al177/blinkencard/README.md

# blinkencard
FPGA based blinky computer emulator
