al177/blinkencard/(threads)

Thread 8 (2019-12-26):

Keep vias away from silk

al177, 2019-12-26:
Insure that vias stay clear of any silk on the 'front panel' back silk layer. Vias break up silkscreen, and can make the fine text on the front panel illegible. Seems to be done mostly well with V2.0, but back silk layer needs more thorough review for future revs.

The only violations of this are around the 'STATUS' legend under the status LED bank. This is an issue on both v1.0 and v2.0 PCBs.

Closed 2023-09-08.

Thread 9 (2019-12-27):

v2.0 BOM errors

al177, 2019-12-27:
- C1, C2 0.01uF cap is 0805, should be 0603
- D2 green SMD LED is R/A, but footprint is not. R/A facing outward is correct, should change footprint to match.

Closed 2023-09-08.

Thread 10 (2019-12-28):

v2.0 - battery connector polarity is opposite the Adafruit standard

al177, 2019-12-28:
Adafruit 1S LiPo cells use JST-PH connectors like this design, but the polarity is opposite of ours.

For next revision, either choose a different connector, or change polarity to match this semi-standard.

Closed 2023-09-08.

Thread 12 (2019-12-28):

v2.0 - Increase silk text and line width on the front panel

al177, 2019-12-28:
JLCPCB does a reasonable job of printing silk, but their process does not seem consistent from run to run as evidenced by minor gaps in some lines in v2.0 vs v1.0.  Increase the line width for graphics and text to avoid this in the future.

Closed 2023-09-08.

Thread 13 (2020-01-10):

Rotate the battery connector 180 degrees

al177, 2020-01-10:
With the battery connector oriented the way it is, the leads from the battery drape over the ESP32 module antenna. Rotate the connector so this doesn't happen.

Closed 2023-09-08.
