al177/blinkencard/kicad/v2.0/blinkencard.pdf

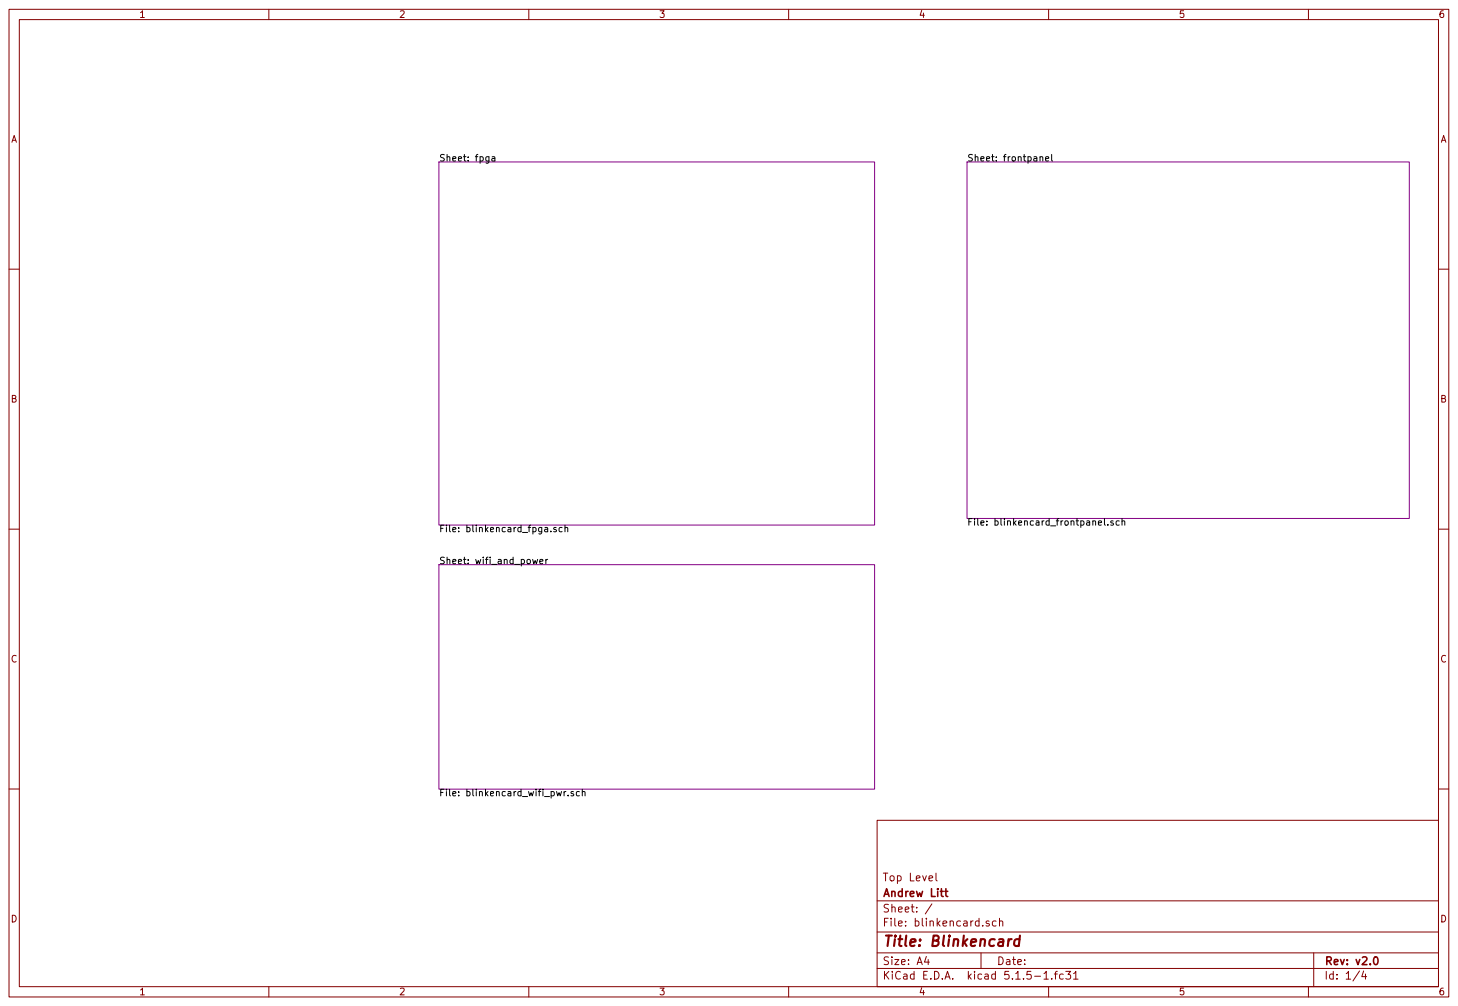
[picture p1: page 1]

File: blinkencard.sch Sheet: / Andrew Litt Top Level

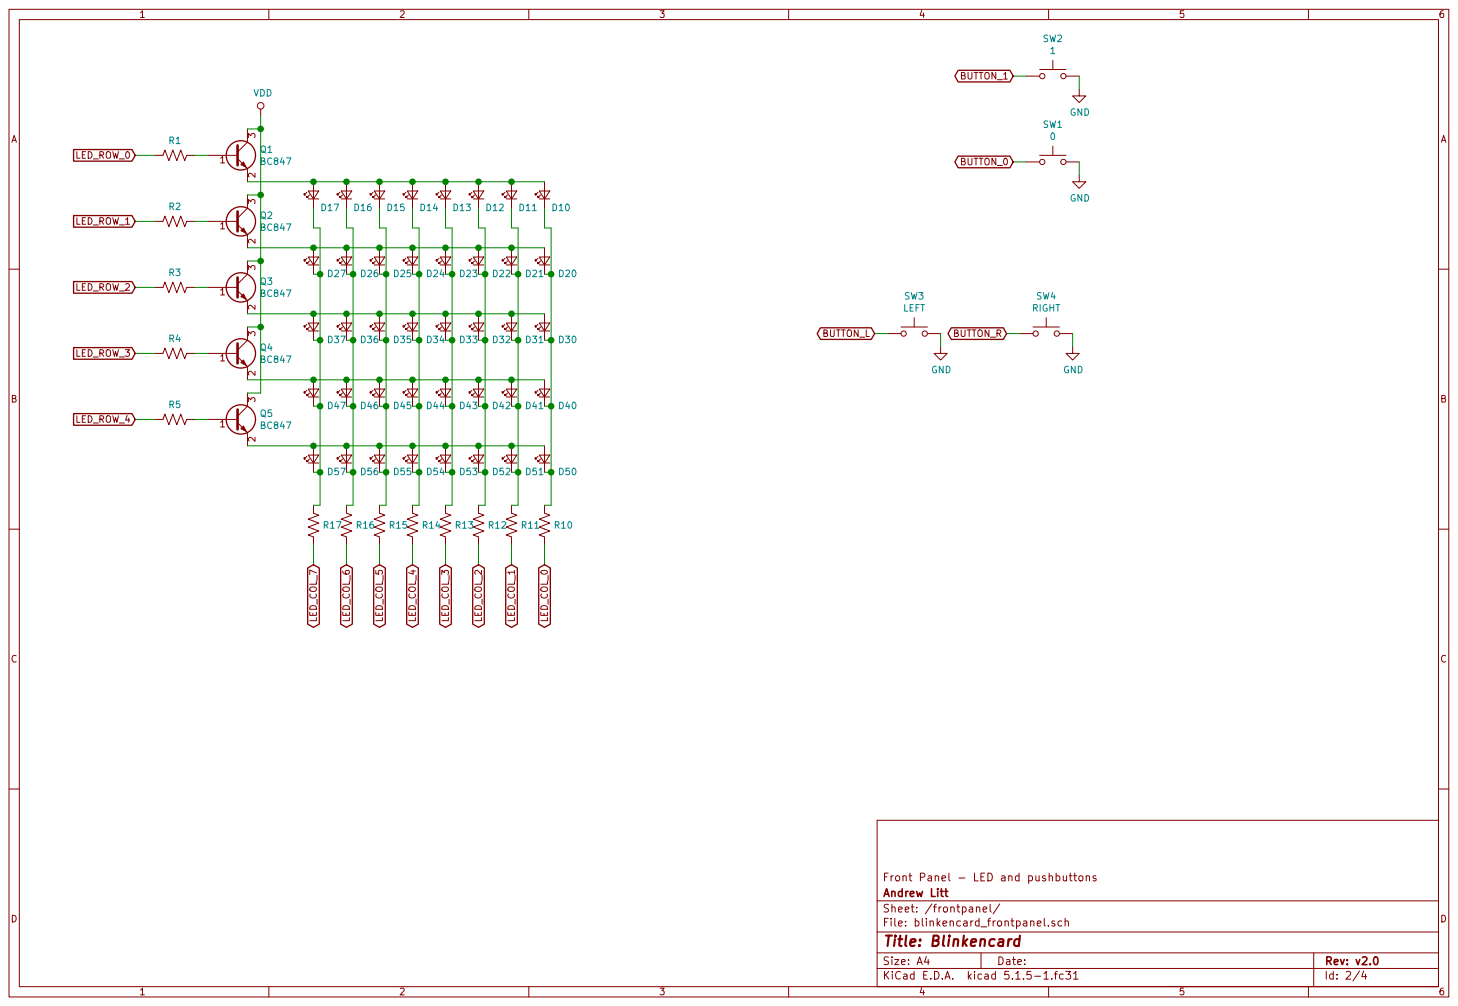
[picture p2: page 2]

Sheet: /frontpanel/ Andrew Litt Front Panel - LED and pushbuttons R15

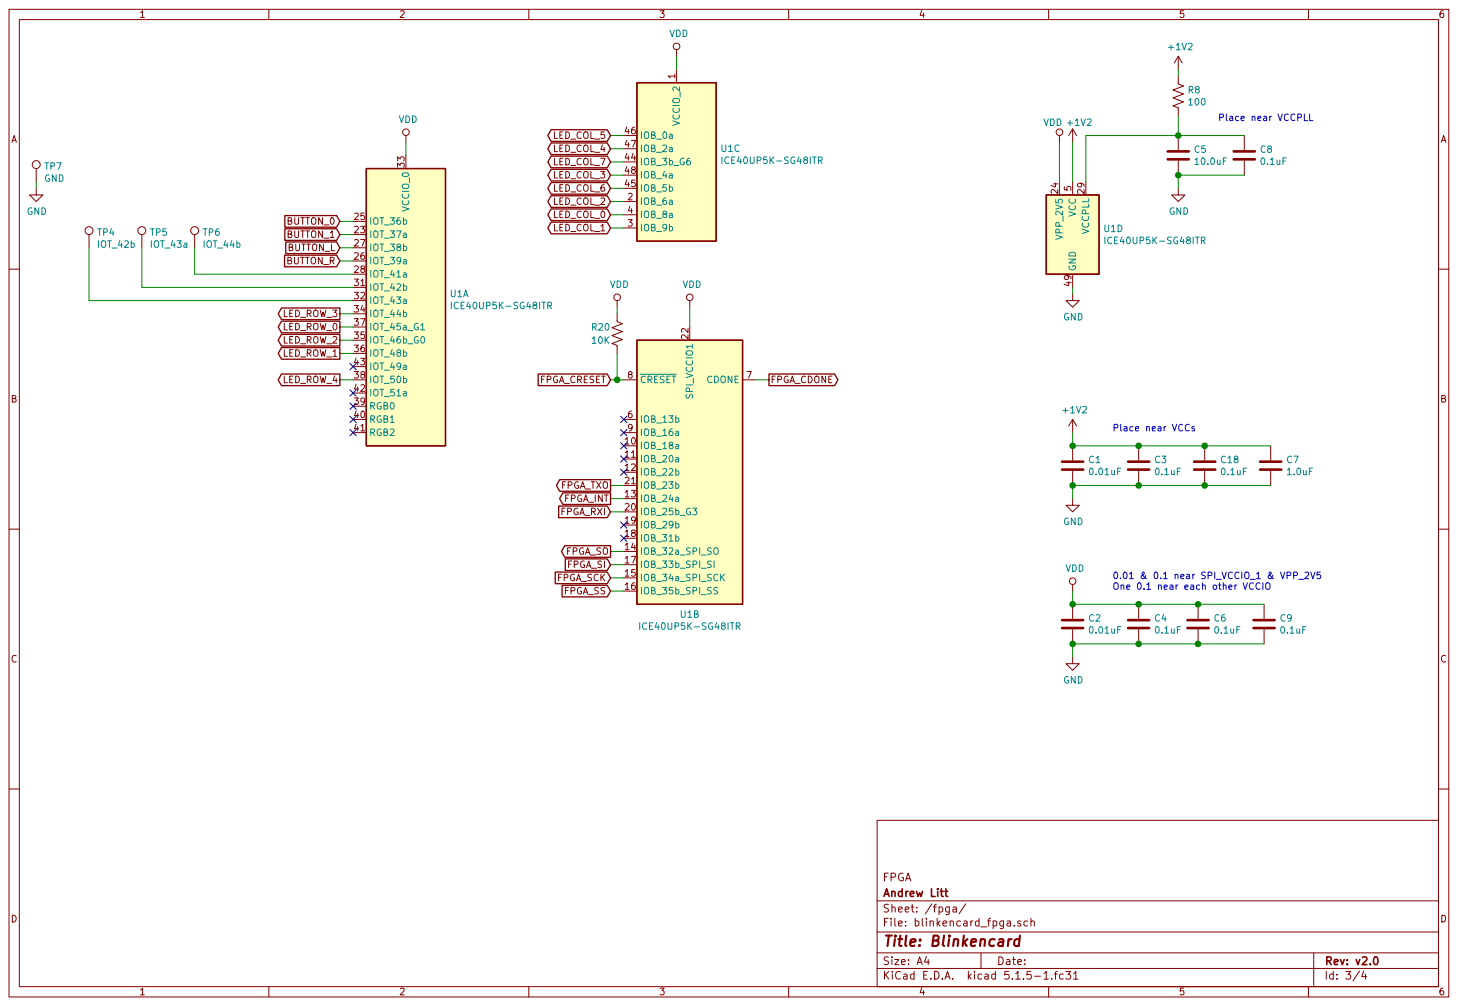
[picture p3: page 3]

Sheet: /fpga/ Andrew Litt FPGA

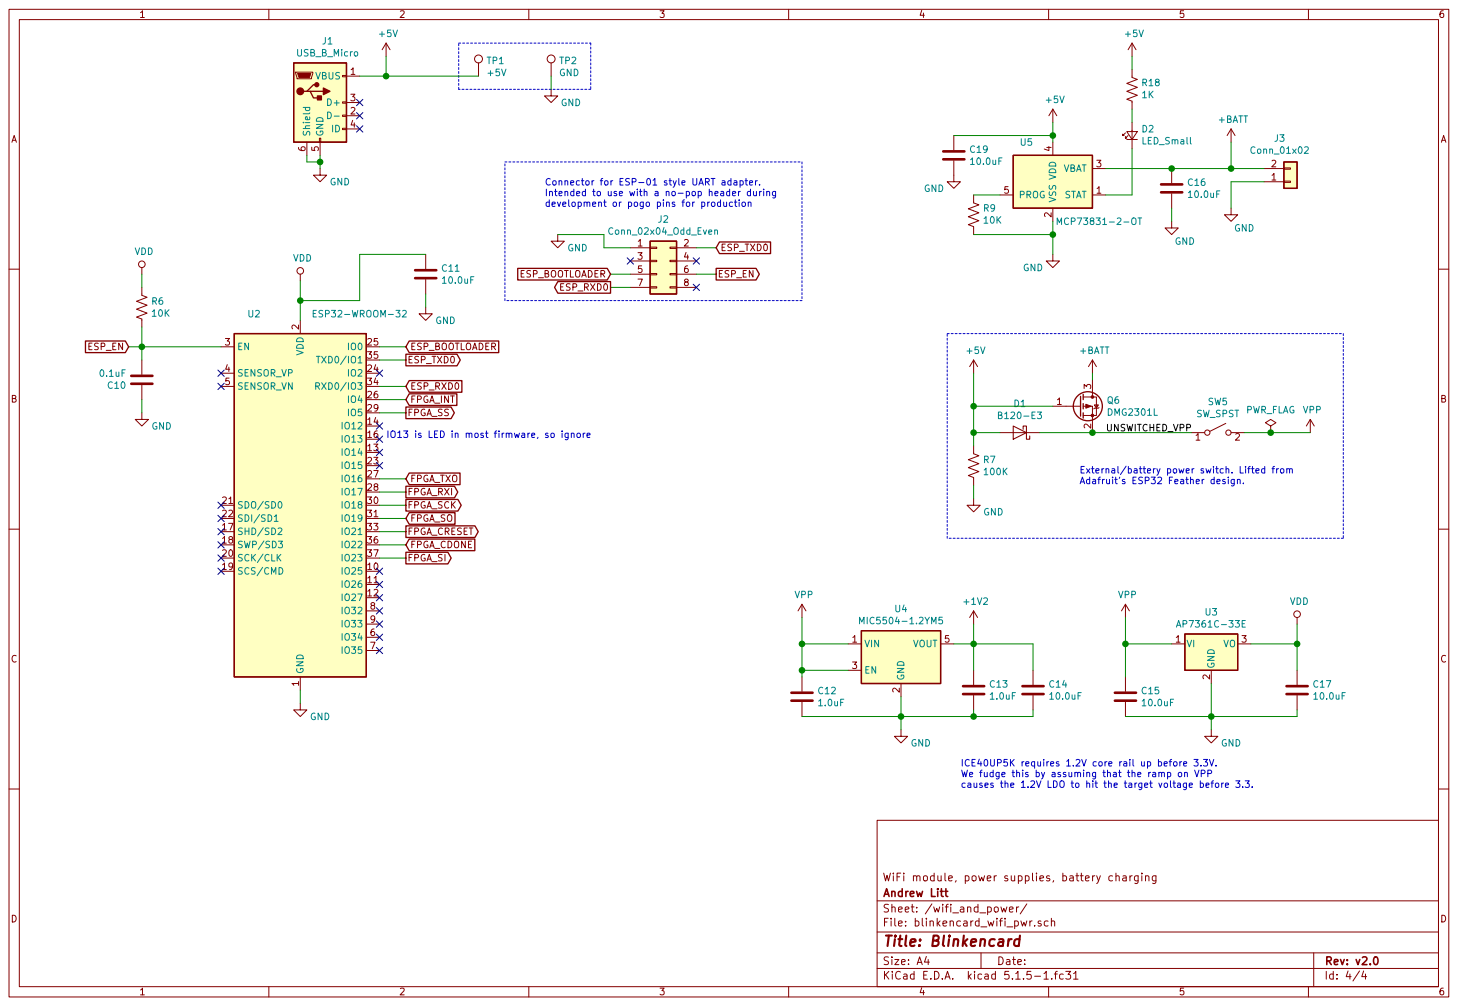
[picture p4: page 4]

Connector for ESP-01 style UART adapter.
Intended to use with a no-pop header during
development or pogo pins for production

2 SCK/CLK 20 SDO/SD0 21 SDI/SD1 22

IO13 is LED in most firmware, so ignore

External/battery power switch. Lifted from
Adafruit's ESP32 Feather design.

ICE40UP5K requires 1.2V core rail up before 3.3V.
We fudge this by assuming that the ramp on VPP
causes the 1.2V LDO to hit the target voltage before 3.3.

Sheet: /wifi_and_power/ Andrew Litt WiFi module, power supplies, battery charging
