al177/blinkencard/kicad/v1.0/blinkencard.pdf

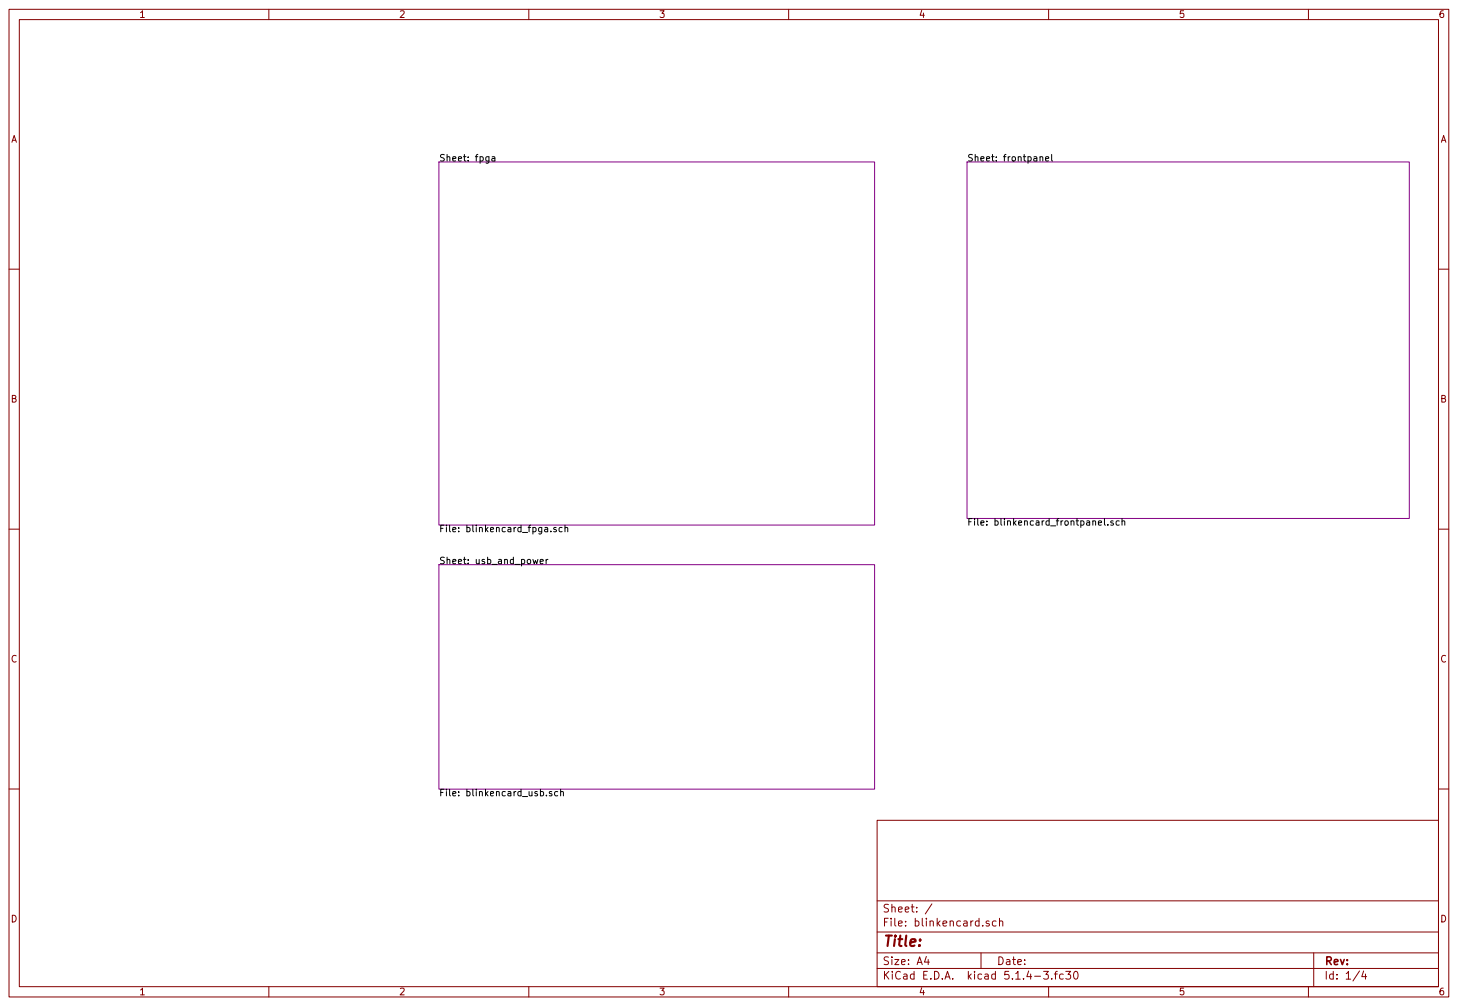
[picture p5: page 1]

Id: 1/4 Title: File: blinkencard.sch Sheet: /

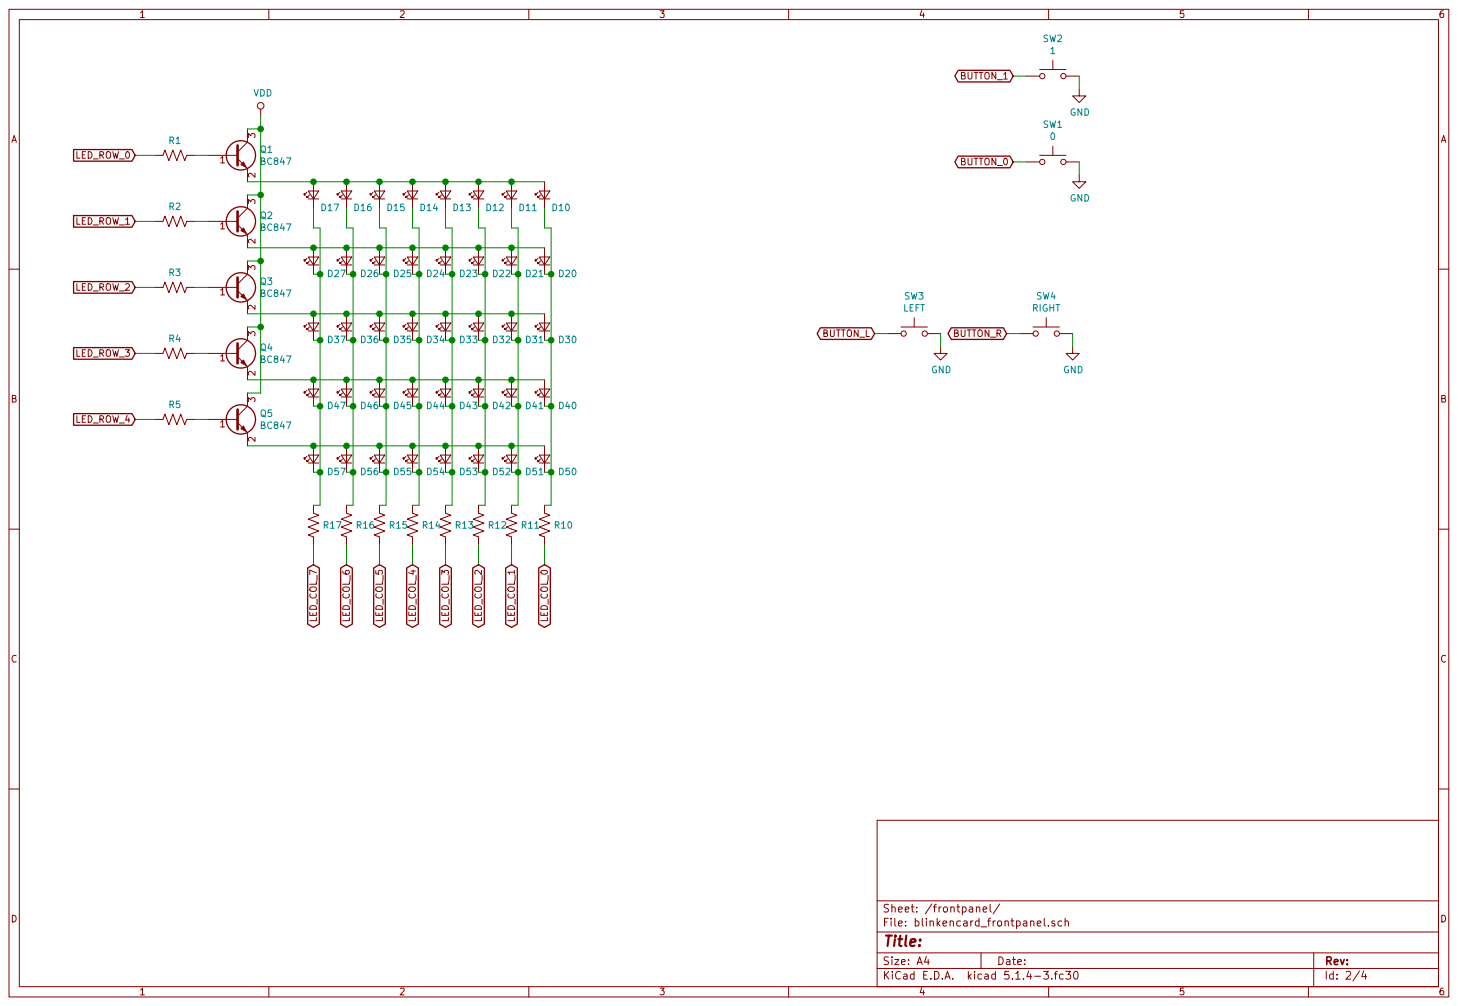
[picture p6: page 2]

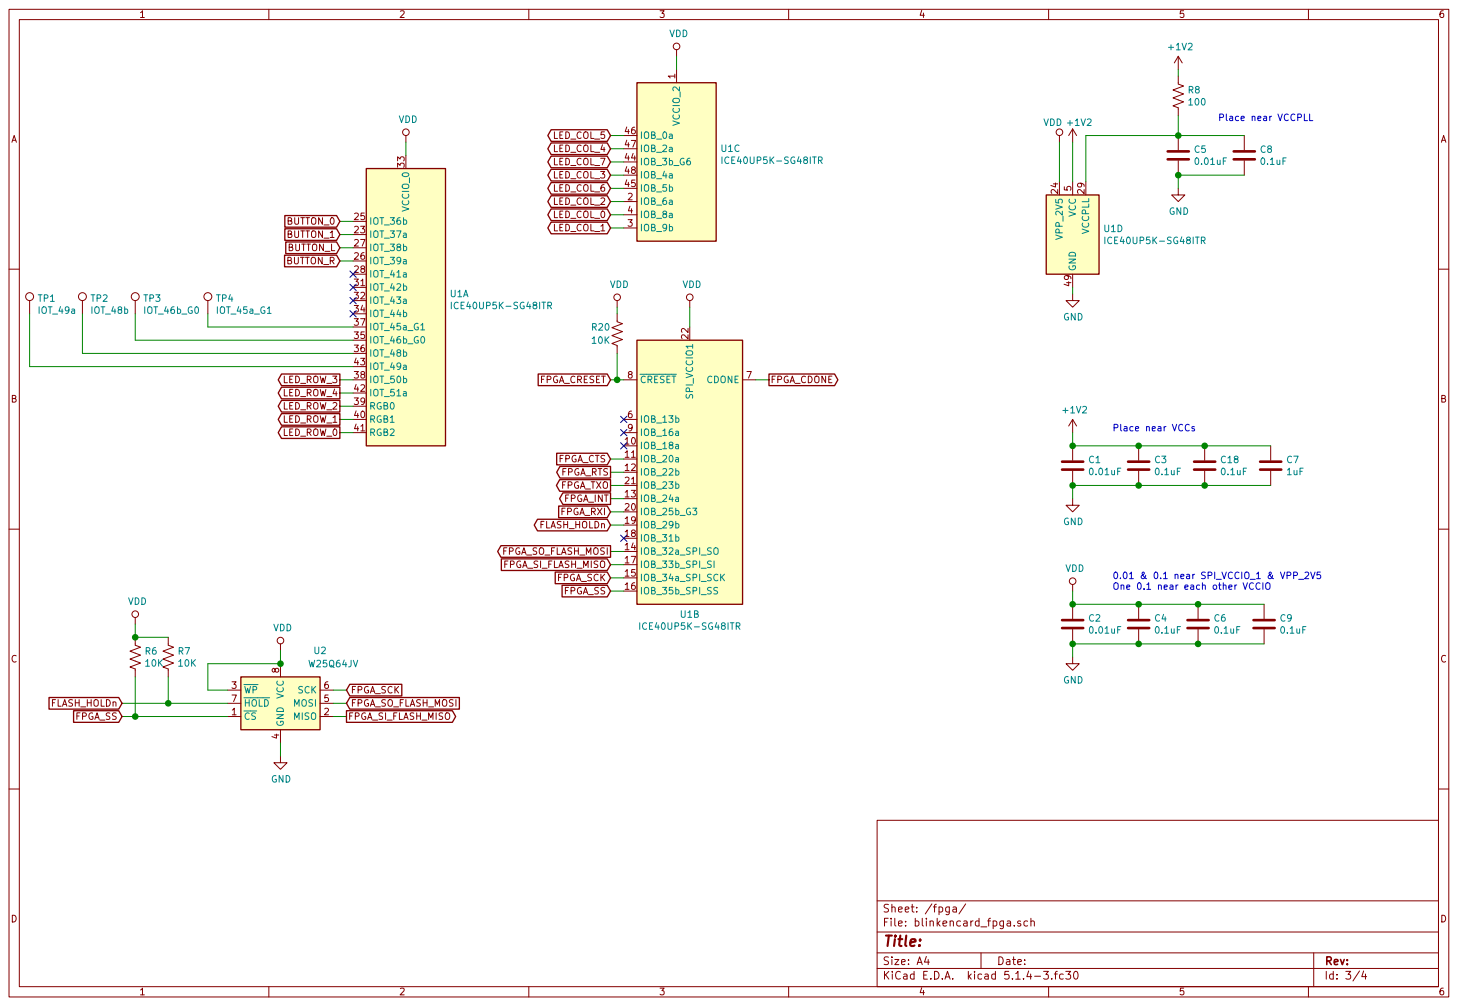
[picture p7: page 3]

Place near VCCs 0.01 & 0.1 near SPI_VCCIO_1 & VPP_2V5 One 0.1 near each other VCCIO

4 MOSI 5 SCK 6 HOLD 7 VCC

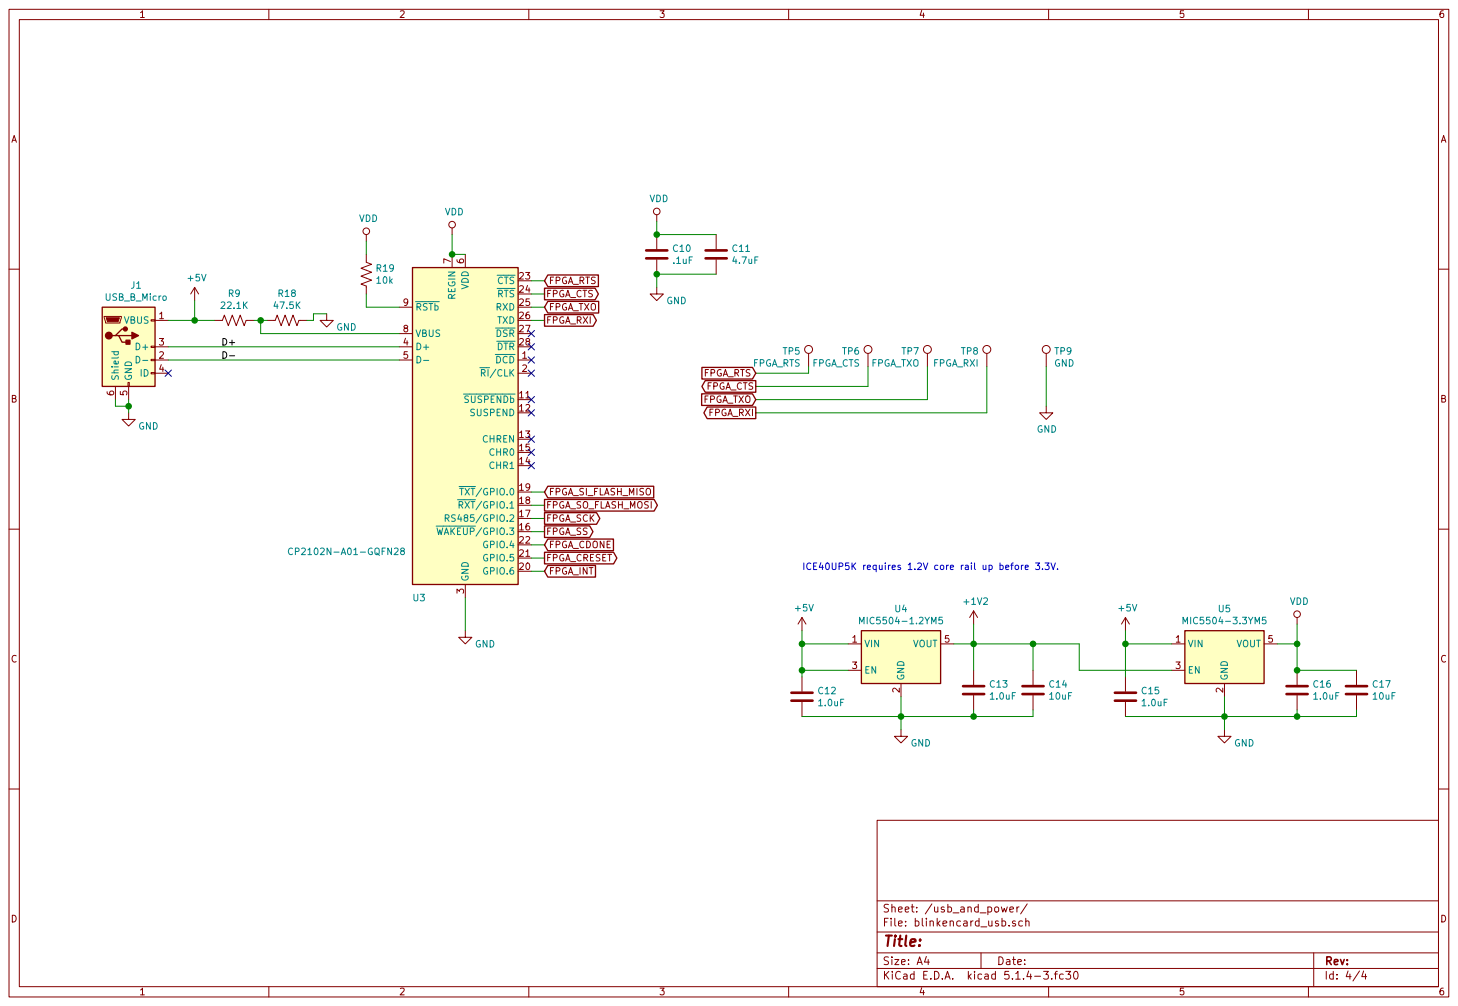
[picture p8: page 4]

ICE40UP5K requires 1.2V core rail up before 3.3V.
