al177/blinkencard/kicad/blinkencard.kicad_pcb

## KiCad design kicad/blinkencard.kicad_pcb (2019-12-19)

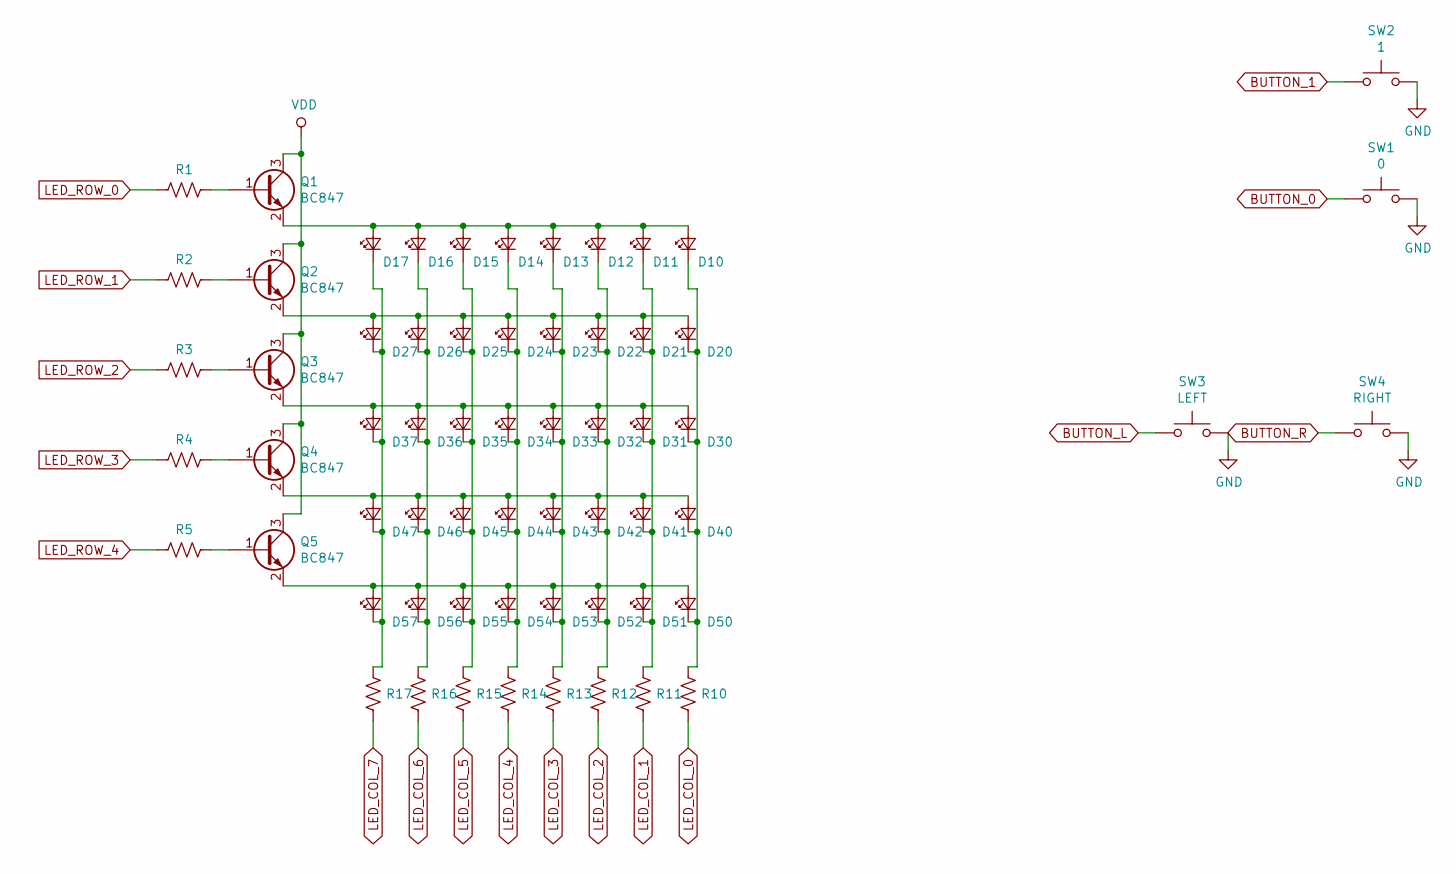
[picture p9: schematic blinkencard_frontpanel.sch, Blinkencard]

Parts:
D10, D11, D12, D13, D14, D15, D16, D17, D20, D21, D22, D23, D24, D25, D26, D27, D30, D31, D32, D33, D34, D35, D36, D37, D40, D41, D42, D43, D44, D45, D46, D47, D50, D51, D52, D53, D54, D55, D56, D57: LED_Small; LED_1206_3216Metric_ReverseMount_Hole1.8x2.4mm; mfg_part LTST-C230KRKT
Q1, Q2, Q3, Q4, Q5: BC847; SOT-23; mfg_part BC847CLT1G
R1, R2, R3, R4, R5: 10K; R_0603_1608Metric; mfg_part RC0603JR-0710KL
R10, R11, R12, R13, R14, R15, R16, R17: 270; R_0603_1608Metric; mfg_part RMCF0603JT270R
SW1: 0; SW_SPST_PTS645; mfg_part PTS645SM50SMTR92 LFS
SW2: 1; SW_SPST_PTS645; mfg_part PTS645SM50SMTR92 LFS
SW3: LEFT; SW_SPST_PTS645; mfg_part PTS645SM50SMTR92 LFS
SW4: RIGHT; SW_SPST_PTS645; mfg_part PTS645SM50SMTR92 LFS

Connections:
BUTTON_0: SW1.1; also elsewhere on the board
BUTTON_1: SW2.1; also elsewhere on the board
BUTTON_L: SW3.1; also elsewhere on the board
BUTTON_R: SW4.1; also elsewhere on the board
GND: SW1.2, SW2.2, SW3.2, SW4.2; also elsewhere on the board
LED_COL_0: R10.2; also elsewhere on the board
LED_COL_1: R11.2; also elsewhere on the board
LED_COL_2: R12.2; also elsewhere on the board
LED_COL_3: R13.2; also elsewhere on the board
LED_COL_4: R14.2; also elsewhere on the board
LED_COL_5: R15.2; also elsewhere on the board
LED_COL_6: R16.2; also elsewhere on the board
LED_COL_7: R17.2; also elsewhere on the board
LED_ROW_0: R1.2; also elsewhere on the board
LED_ROW_1: R2.2; also elsewhere on the board
LED_ROW_2: R3.2; also elsewhere on the board
LED_ROW_3: R4.2; also elsewhere on the board
LED_ROW_4: R5.2; also elsewhere on the board
unnamed: D10.1 (K), D20.1 (K), D30.1 (K), D40.1 (K), D50.1 (K), R10.1
unnamed: D10.2 (A), D11.2 (A), D12.2 (A), D13.2 (A), D14.2 (A), D15.2 (A), D16.2 (A), D17.2 (A), Q1.2 (E)
unnamed: D11.1 (K), D21.1 (K), D31.1 (K), D41.1 (K), D51.1 (K), R11.1
unnamed: D12.1 (K), D22.1 (K), D32.1 (K), D42.1 (K), D52.1 (K), R12.1
unnamed: D13.1 (K), D23.1 (K), D33.1 (K), D43.1 (K), D53.1 (K), R13.1
unnamed: D14.1 (K), D24.1 (K), D34.1 (K), D44.1 (K), D54.1 (K), R14.1
unnamed: D15.1 (K), D25.1 (K), D35.1 (K), D45.1 (K), D55.1 (K), R15.1
unnamed: D16.1 (K), D26.1 (K), D36.1 (K), D46.1 (K), D56.1 (K), R16.1
unnamed: D17.1 (K), D27.1 (K), D37.1 (K), D47.1 (K), D57.1 (K), R17.1
unnamed: D20.2 (A), D21.2 (A), D22.2 (A), D23.2 (A), D24.2 (A), D25.2 (A), D26.2 (A), D27.2 (A), Q2.2 (E)
unnamed: D30.2 (A), D31.2 (A), D32.2 (A), D33.2 (A), D34.2 (A), D35.2 (A), D36.2 (A), D37.2 (A), Q3.2 (E)
unnamed: D40.2 (A), D41.2 (A), D42.2 (A), D43.2 (A), D44.2 (A), D45.2 (A), D46.2 (A), D47.2 (A), Q4.2 (E)
unnamed: D50.2 (A), D51.2 (A), D52.2 (A), D53.2 (A), D54.2 (A), D55.2 (A), D56.2 (A), D57.2 (A), Q5.2 (E)
unnamed: Q1.1 (B), R1.1
unnamed: Q2.1 (B), R2.1
unnamed: Q3.1 (B), R3.1
unnamed: Q4.1 (B), R4.1
unnamed: Q5.1 (B), R5.1
VDD: Q1.3 (C), Q2.3 (C), Q3.3 (C), Q4.3 (C), Q5.3 (C); also elsewhere on the board

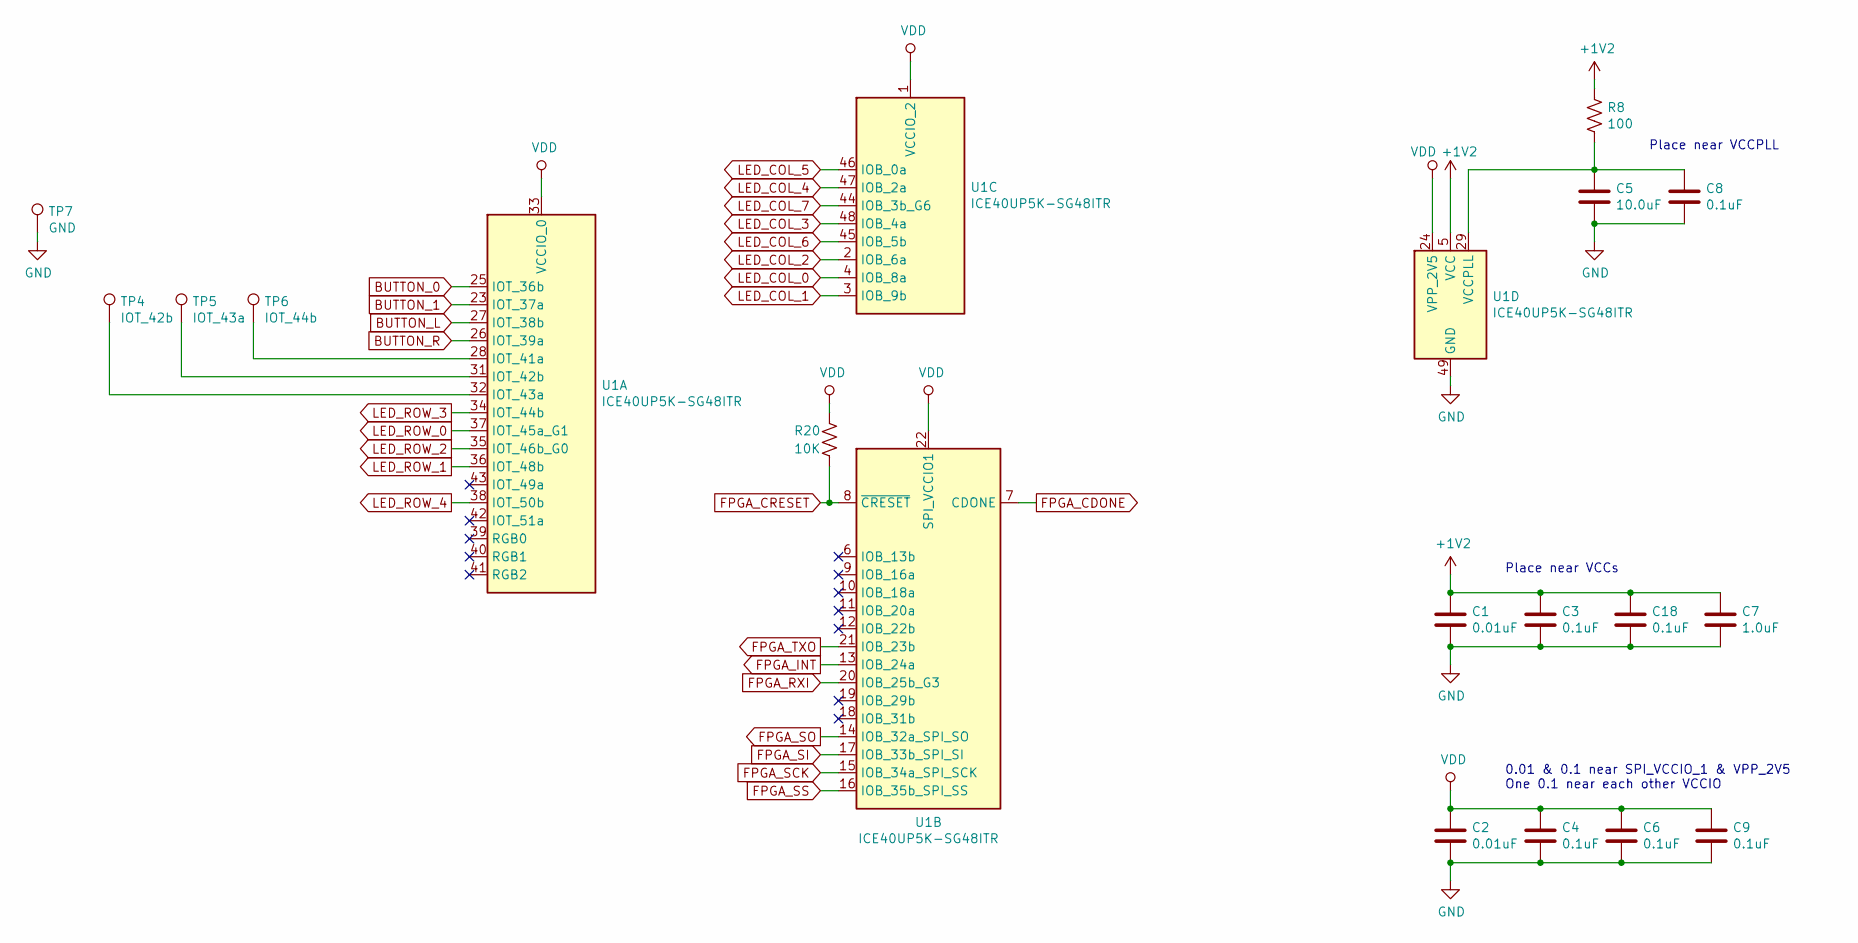
[picture p10: schematic blinkencard_fpga.sch, Blinkencard]

Parts:
C1, C2: 0.01uF; C_0603_1608Metric; mfg_part CL21B103KBANNNC
C3, C4, C6, C8, C9, C18: 0.1uF; C_0603_1608Metric; mfg_part CL10F104ZO8NNNC
C5: 10.0uF; C_0805_2012Metric; mfg_part CL21A106KQCLRNC
C7: 1.0uF; C_0805_2012Metric; mfg_part CL21B105KOFNNNG
R8: 100; R_0603_1608Metric; mfg_part RC0603JR-07100RL
R20: 10K; R_0603_1608Metric; mfg_part RC0603JR-0710KL
TP4: IOT_42b; TestPoint_Pad_D1.5mm; mfg_part NP
TP5: IOT_43a; TestPoint_Pad_D1.5mm; mfg_part NP
TP6: IOT_44b; TestPoint_Pad_D1.5mm; mfg_part NP
TP7: GND; TestPoint_Pad_D1.5mm; mfg_part NP
U1: ICE40UP5K-SG48ITR; QFN-48-1EP_7x7mm_P0.5mm_EP5.15x5.15mm_ThermalVias; mfg_part ICE40UP5K-SG48I

Connections:
+1V2: C1.1, C3.1, C7.1, C18.1, R8.1, U1.5 (VCC), U1.30 (VCC); also elsewhere on the board
BUTTON_0: U1.25 (IOT_36b); also elsewhere on the board
BUTTON_1: U1.23 (IOT_37a); also elsewhere on the board
BUTTON_L: U1.27 (IOT_38b); also elsewhere on the board
BUTTON_R: U1.26 (IOT_39a); also elsewhere on the board
FPGA_CDONE: U1.7 (CDONE); also elsewhere on the board
FPGA_CRESET: R20.2, U1.8 (~CRESET); also elsewhere on the board
FPGA_INT: U1.13 (IOB_24a); also elsewhere on the board
FPGA_RXI: U1.20 (IOB_25b_G3); also elsewhere on the board
FPGA_SCK: U1.15 (IOB_34a_SPI_SCK); also elsewhere on the board
FPGA_SI: U1.17 (IOB_33b_SPI_SI); also elsewhere on the board
FPGA_SO: U1.14 (IOB_32a_SPI_SO); also elsewhere on the board
FPGA_SS: U1.16 (IOB_35b_SPI_SS); also elsewhere on the board
FPGA_TXO: U1.21 (IOB_23b); also elsewhere on the board
GND: C1.2, C2.2, C3.2, C4.2, C5.2, C6.2, C7.2, C8.2, C9.2, C18.2, TP7.1, U1.49 (GND); also elsewhere on the board
LED_COL_0: U1.4 (IOB_8a); also elsewhere on the board
LED_COL_1: U1.3 (IOB_9b); also elsewhere on the board
LED_COL_2: U1.2 (IOB_6a); also elsewhere on the board
LED_COL_3: U1.48 (IOB_4a); also elsewhere on the board
LED_COL_4: U1.47 (IOB_2a); also elsewhere on the board
LED_COL_5: U1.46 (IOB_0a); also elsewhere on the board
LED_COL_6: U1.45 (IOB_5b); also elsewhere on the board
LED_COL_7: U1.44 (IOB_3b_G6); also elsewhere on the board
LED_ROW_0: U1.37 (IOT_45a_G1); also elsewhere on the board
LED_ROW_1: U1.36 (IOT_48b); also elsewhere on the board
LED_ROW_2: U1.35 (IOT_46b_G0); also elsewhere on the board
LED_ROW_3: U1.34 (IOT_44b); also elsewhere on the board
LED_ROW_4: U1.38 (IOT_50b); also elsewhere on the board
unnamed: C5.1, C8.1, R8.2, U1.29 (VCCPLL)
unnamed: TP4.1, U1.32 (IOT_43a)
unnamed: TP5.1, U1.31 (IOT_42b)
unnamed: TP6.1, U1.28 (IOT_41a)
VDD: C2.1, C4.1, C6.1, C9.1, R20.1, U1.1 (VCCIO_2), U1.22 (SPI_VCCIO1), U1.24 (VPP_2V5), U1.33 (VCCIO_0); also elsewhere on the board

Notes on the sheet:
0.01 & 0.1 near SPI_VCCIO_1 & VPP_2V5 One 0.1 near each other VCCIO
Place near VCCs
Place near VCCPLL

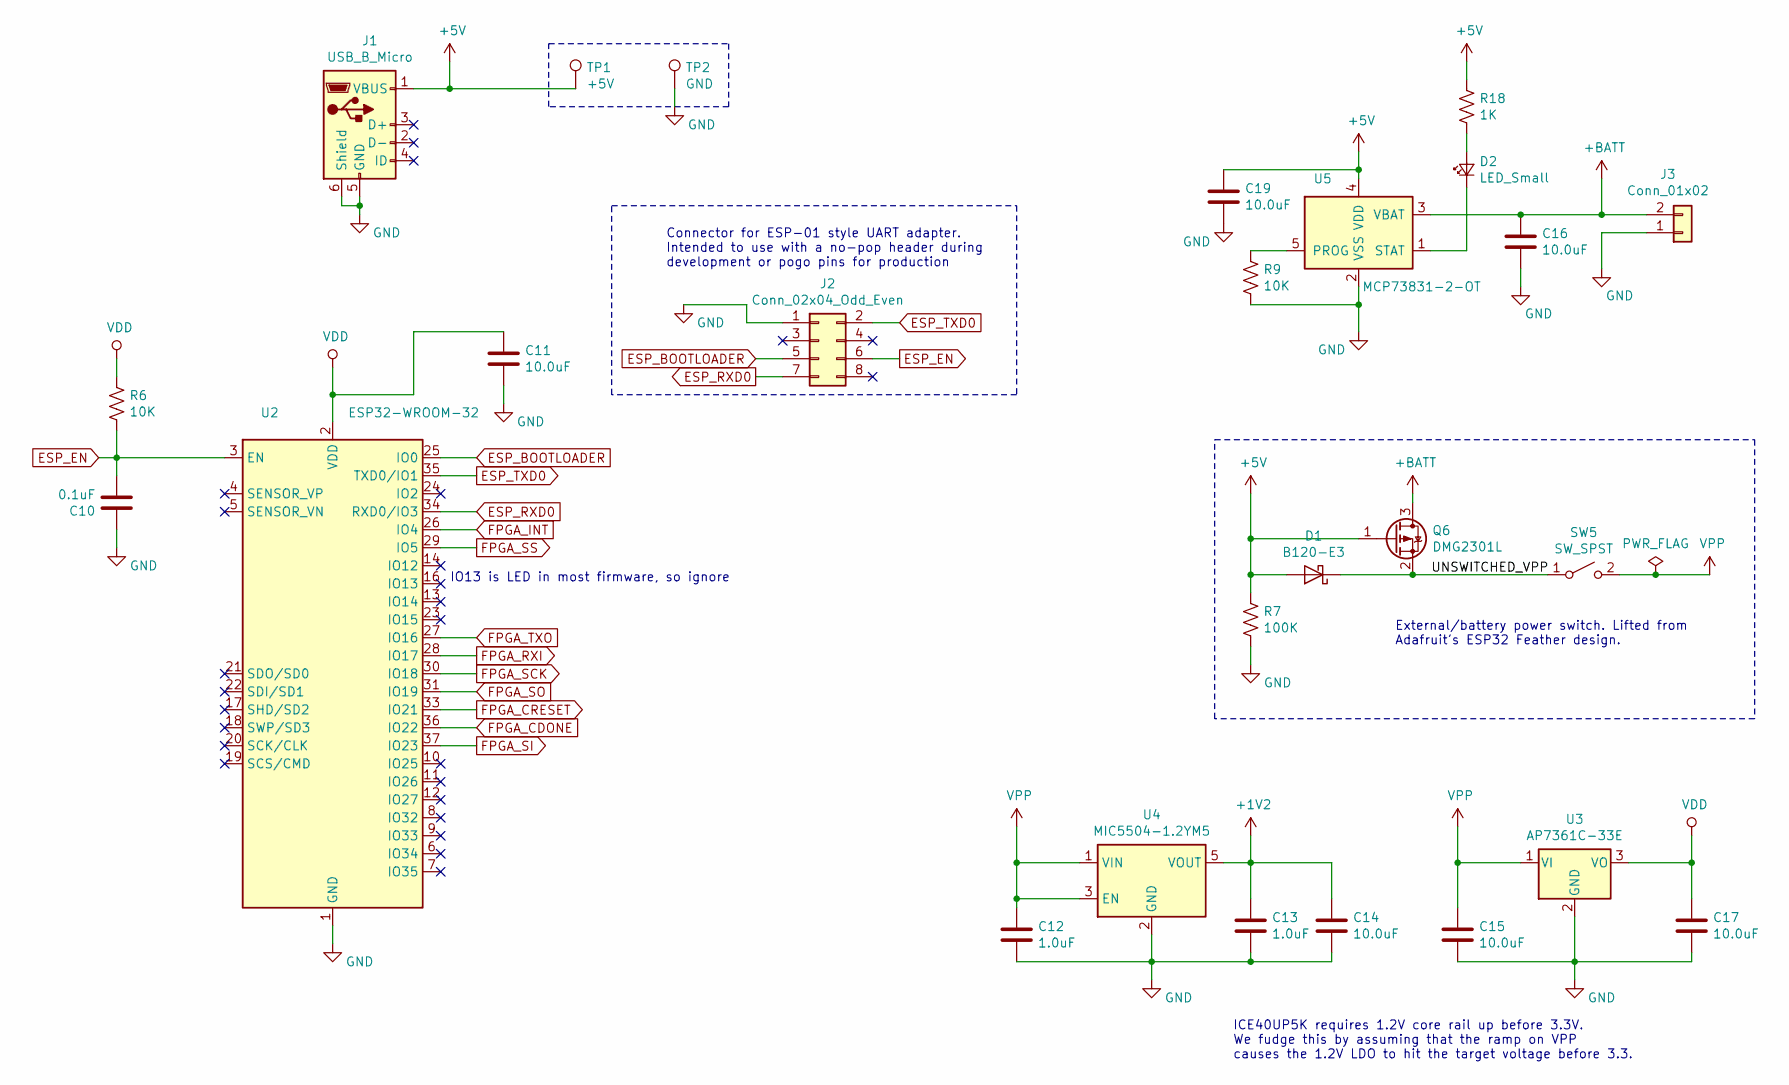
[picture p11: schematic blinkencard_wifi_pwr.sch, Blinkencard]

Parts:
C10: 0.1uF; C_0603_1608Metric; mfg_part CL10F104ZO8NNNC
C11, C14, C15, C16, C17, C19: 10.0uF; C_0805_2012Metric; mfg_part CL21A106KQCLRNC
C12, C13: 1.0uF; C_0805_2012Metric; mfg_part CL21B105KOFNNNG
D1: B120-E3; D_SMA; mfg_part B120-E3/61T
D2: LED_Small; LED_0805_2012Metric; mfg_part LTST-S220GKT
J1: USB_B_Micro; USB_Micro-B_Molex-105017-0001; mfg_part 105017-0001
J2: Conn_02x04_Odd_Even; PinHeader_2x04_P2.54mm_Vertical_SMD; mfg_part 54202-S0804LF
J3: Conn_01x02; JST_PH_S2B-PH-SM4-TB_1x02-1MP_P2.00mm_Horizontal; mfg_part S2B-PH-SM4-TB(LF)(SN)
Q6: DMG2301L; SOT-23; mfg_part DMG2301L-7
R6, R9: 10K; R_0603_1608Metric; mfg_part RC0603JR-0710KL
R7: 100K; R_0603_1608Metric; mfg_part RC0603JR-07100KL
R18: 1K; R_0603_1608Metric; mfg_part RC0603JR-071KL
SW5: SW_SPST; SW_SPDT_CK-JS102011SAQN; mfg_part JS102011SAQN
TP1: +5V; TestPoint_Pad_D1.5mm; mfg_part NP
TP2: GND; TestPoint_Pad_D1.5mm; mfg_part NP
U2: ESP32-WROOM-32; mfg_part ESP32-WROOM-32D
U3: AP7361C-33E; SOT-223-3_TabPin2; mfg_part AP7361C-33E-13
U4: MIC5504-1.2YM5; SOT-23-5; mfg_part MIC5504-1.2YM5
U5: MCP73831-2-OT; SOT-23-5; mfg_part MCP73831T-2ATI/OT

Connections:
+1V2: C13.1, C14.1, U4.5 (VOUT); also elsewhere on the board
+5V: C19.1, D1.2 (A), J1.1 (VBUS), Q6.1 (G), R7.1, R18.2, TP1.1, U5.4 (VDD)
+BATT: C16.1, J3.2, Q6.3 (D), U5.3 (VBAT)
/wifi_and_power/UNSWITCHED_VPP: D1.1 (K), Q6.2 (S), SW5.1 (A)
ESP_BOOTLOADER: J2.5, U2.25 (IO0)
ESP_EN: C10.2, J2.6, R6.2, U2.3 (EN)
ESP_RXD0: J2.7, U2.34 (RXD0/IO3)
ESP_TXD0: J2.2, U2.35 (TXD0/IO1)
FPGA_CDONE: U2.36 (IO22); also elsewhere on the board
FPGA_CRESET: U2.33 (IO21); also elsewhere on the board
FPGA_INT: U2.26 (IO4); also elsewhere on the board
FPGA_RXI: U2.28 (IO17); also elsewhere on the board
FPGA_SCK: U2.30 (IO18); also elsewhere on the board
FPGA_SI: U2.37 (IO23); also elsewhere on the board
FPGA_SO: U2.31 (IO19); also elsewhere on the board
FPGA_SS: U2.29 (IO5); also elsewhere on the board
FPGA_TXO: U2.27 (IO16); also elsewhere on the board
GND: C10.1, C11.2, C12.2, C13.2, C14.2, C15.2, C16.2, C17.2, C19.2, J1.5 (GND), J1.6 (Shield), J2.1, J3.1, R7.2, R9.1, TP2.1, U2.1 (GND), U2.15 (GND), U2.38 (GND), U2.39 (GND), U3.2 (GND), U4.2 (GND), U5.2 (VSS); also elsewhere on the board
unnamed: D2.1 (K), U5.1 (STAT)
unnamed: D2.2 (A), R18.1
unnamed: R9.2, U5.5 (PROG)
VDD: C11.1, C17.1, R6.1, U2.2 (VDD), U3.3 (VO); also elsewhere on the board
VPP: C12.1, C15.1, SW5.2 (B), U3.1 (VI), U4.1 (VIN), U4.3 (EN)

Notes on the sheet:
ICE40UP5K requires 1.2V core rail up before 3.3V. We fudge this by assuming that the ramp on VPP causes the 1.2V LDO to hit the target voltage before 3.3.
IO13 is LED in most firmware, so ignore
Connector for ESP-01 style UART adapter. Intended to use with a no-pop header during development or pogo pins for production
External/battery power switch. Lifted from Adafruit's ESP32 Feather design.

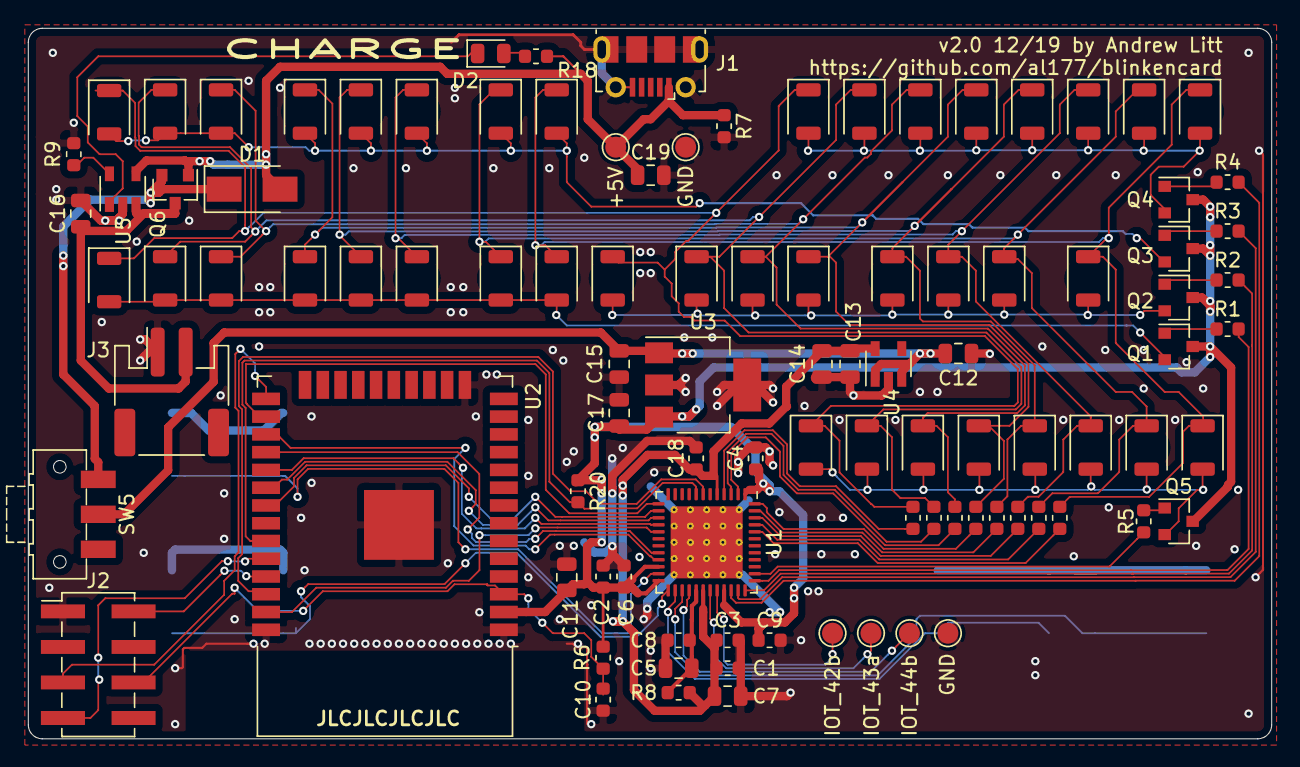
[picture p12: board blinkencard.kicad_pcb from above]

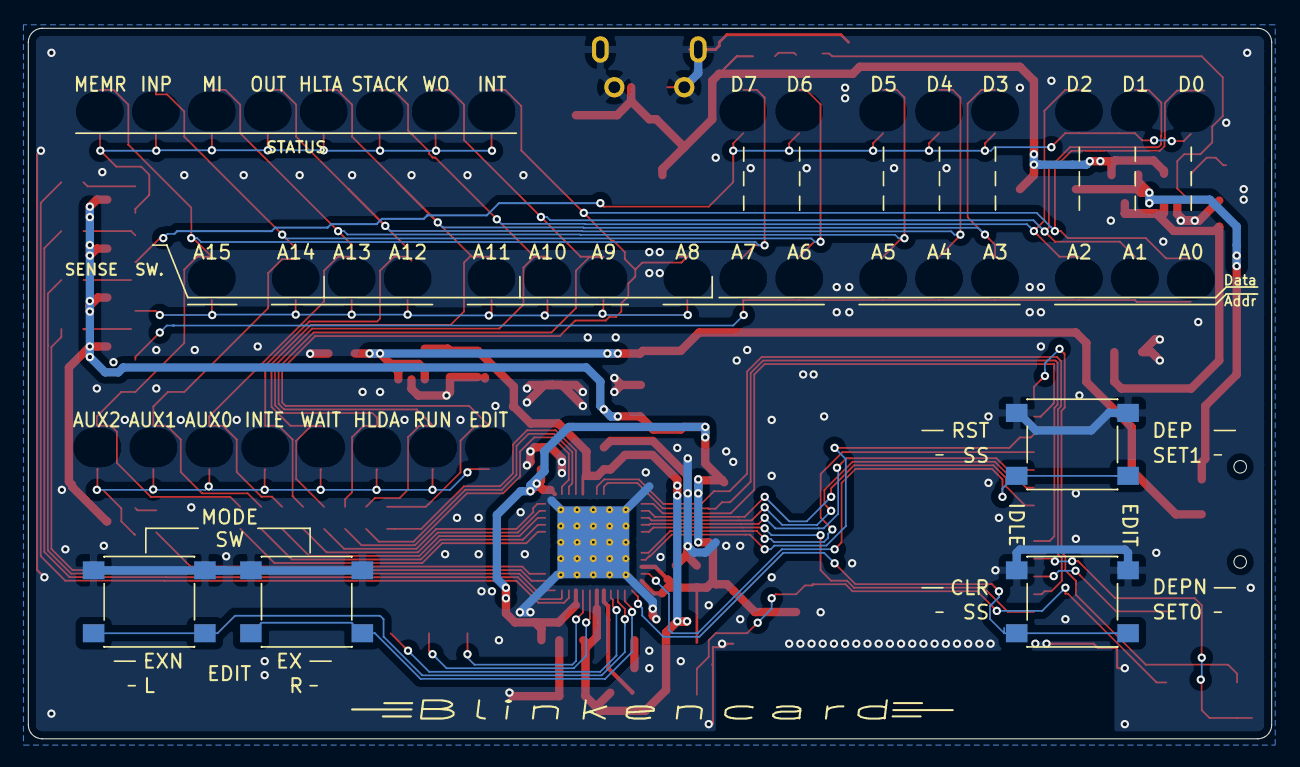
[picture p13: board blinkencard.kicad_pcb from below]

Board: 2 copper layers, 88.9 x 50.8 mm, 105 parts (4 on the bottom side), 62 nets.
