al177/blinkencard/micropython/boot.py

# This file is executed on every boot (including wake-boot from deepsleep)
#import esp
#esp.osdebug(None)
import webrepl
webrepl.start()
import network
ap=network.WLAN(network.AP_IF)
ap.active(True)
import iceboot
iceboot.boot('altair.bin')
import term_server
term_server.go()
