al177/blinkencard/(commit log)

2019-11-11 Initial add of WIP board
    [blinkencard.kicad_pcb, blinkencard.sch, blinkencard_fpga.sch, blinkencard_frontpanel.sch, blinkencard_wifi.sch]
2019-11-11 LED layout in progress
    [blinkencard.kicad_pcb]
2019-11-12 More LED routing
    [blinkencard.kicad_pcb]
2019-11-12 Start routing LEDs. Start ESP32 integration
    [blinkencard.kicad_pcb, blinkencard_fpga.sch, blinkencard_wifi.sch]
2019-11-13 Decided to use bottom-firing LEDs. Need to reassign LED refdes
    [blinkencard.kicad_pcb]
2019-11-15 More flat front panel work
    [blinkencard.kicad_pcb]
2019-11-16 Use CP2102A USB-UART and GPIO instead of ESP32 to keep it simple. Add power section and start routing.
    [blinkencard.kicad_pcb, blinkencard.sch, blinkencard_fpga.sch, blinkencard_frontpanel.sch, blinkencard_usb.sch, blinkencard_wifi.sch]
2019-11-16 LED routing
    [blinkencard.kicad_pcb, blinkencard_fpga.sch]
2019-11-17 Mostly routed
    [blinkencard.kicad_pcb, blinkencard_fpga.sch, blinkencard_usb.sch]
2019-11-17 Routing complete. DRC passes. Need to fix silk around LEDs and do final check
    [blinkencard.kicad_pcb, blinkencard_fpga.sch, blinkencard_usb.sch]
2019-11-17 Fix LED silk, minor routing cleanups
    [blinkencard.kicad_pcb]
2019-11-18 Refdes silk placement, label cleanup, ground via cleanup
    [blinkencard.kicad_pcb]
2019-11-18 Move buttons to more sensible locations, finalize silk, tape out v1.0
    [blinkencard-B_Cu.gbr, blinkencard-B_Mask.gbr, blinkencard-B_SilkS.gbr, blinkencard-Edge_Cuts.gbr, blinkencard-F_Cu.gbr, blinkencard-F_Mask.gbr, blinkencard-F_Paste.gbr, blinkencard-F_SilkS.gbr]
2019-11-18 Fix minor ground plane issue before submitting v1.0
    [blinkencard-B_Cu.gbr, blinkencard-B_Mask.gbr, blinkencard-B_SilkS.gbr, blinkencard-Edge_Cuts.gbr, blinkencard-F_Cu.gbr, blinkencard-F_Mask.gbr, blinkencard-F_Paste.gbr, blinkencard-F_SilkS.gbr]
2019-11-20 Start v1.1 - minor fixes:
    - Replace 4.7uF caps with 10uF
    - Replace 0.01uF cap in the FPGA VCCPLL filter with 10uF per Lattice's design guideline
    - All <1uF caps to 0603 sizes, 1-10uF to 0805
    - Make TP? values match between schem and PCB
    - Sanitize component values for BOM export consistency
    [blinkencard.kicad_pcb, blinkencard_fpga.sch, blinkencard_usb.sch]
2019-11-30 Start v2.0 - change USB-UART to ESP32 and bugfixes
    [blinkencard.kicad_pcb, blinkencard.sch, blinkencard_fpga.sch, blinkencard_frontpanel.sch, blinkencard_usb.sch, blinkencard_wifi_pwr.sch]
2019-12-02 Finish routing v2.0.
    [blinkencard.kicad_pcb]
2019-12-03 Fix RESET and GPIO0 (bootload) on the programming header to match an actual ESP-01 programmer
    [blinkencard.kicad_pcb, blinkencard_wifi_pwr.sch]
2019-12-05 Finish converting to ESP32, start on adding LiPo power
    [blinkencard.kicad_pcb, blinkencard_wifi_pwr.sch]
2019-12-16 First pass routing complete w/ LiPo charging
    [blinkencard.kicad_pcb, blinkencard_wifi_pwr.sch]
2019-12-16 Layout complete for v2 build. Needs review.
    [blinkencard.kicad_pcb]
2019-12-18 Add more sch comments
    [blinkencard_wifi_pwr.sch]
2019-12-18 Add cap across 5V for charger
    [blinkencard.kicad_pcb, blinkencard_wifi_pwr.sch]
2019-12-19 v2.0 release - clean silk, add order number placeholder for JLCPCB, add MFG PN in components for BOM, add BOM, add STEP, generate fab outputs
    [blinkencard-B_Cu.gbr, blinkencard-B_Mask.gbr, blinkencard-B_SilkS.gbr, blinkencard-Edge_Cuts.gbr, blinkencard-F_Cu.gbr, blinkencard-F_Mask.gbr, blinkencard-F_Paste.gbr, blinkencard-F_SilkS.gbr]
2020-01-12 Switch to mainline Micropython, so update iceboot for the mainline machine APIs
2020-01-16 Add OpenSCAD case
    [blinkencard_case.scad]
2020-02-25 First commit of telnet to UART server for Blinkencard
2020-02-25 Case for Blinkencard with a LiPo pouch cell
    [blinkencard_case.scad]
2025-05-23 Add filament handle
    [blinkencard_case.scad]
2025-05-23 Add debug port cover and reinforce back case
    [blinkencard_case.scad, debug_plug.scad]
2025-05-25 Slightly thicker case to accomodate 1100mAh 603449 battery
    [blinkencard_case.scad, debug_plug.scad]
2025-05-25 Loader fix due to new (better) file.read() behavior
    [iceboot.py]
2025-05-25 Remove debug print in loader
2025-06-17 case: Make plug sturdier and easier to remove
    Add a bridge at the top of the debug plug for lateral stability.
    Also make the removal holes larger to fit more tools.
    [debug_plug.scad]
